AndreeaFG/Project-Circuit-for-controlling-the-concentration-of-CO-in-an-enclosure/PROIECTTCAD.png

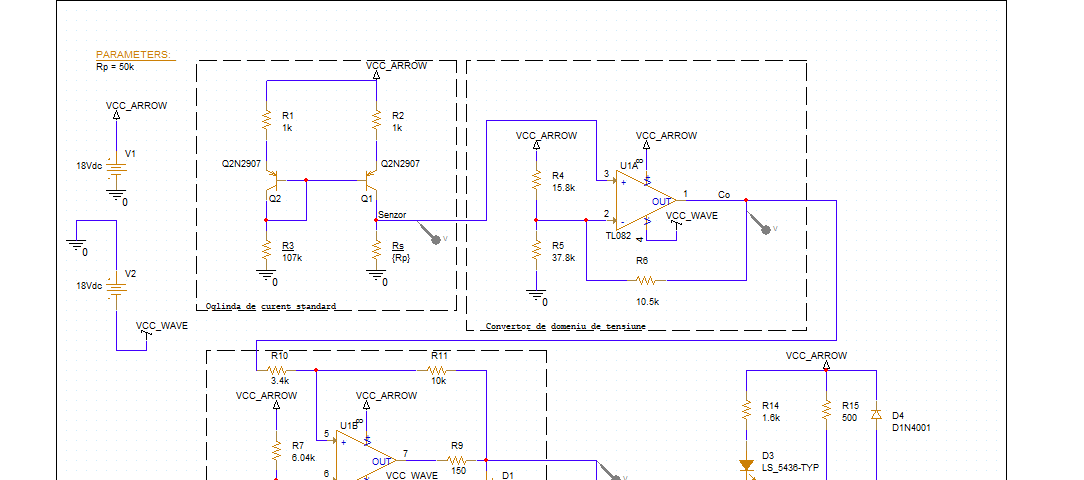
PROIECTTCAD.png
