AndreeaFG/Project-Circuit-for-controlling-the-concentration-of-CO-in-an-enclosure/caract.cir

** Profile: "SCHEMATIC3-caract"  [ C:\Users\Septimiu\Documents\Didactic\alte\2023_2024\tcad\SenzorCO_Orcad\ProiectTCAD-PSpiceFiles\SCHEMATIC3\caract.sim ] 

** Creating circuit file "caract.cir" 
** WARNING: THIS AUTOMATICALLY GENERATED FILE MAY BE OVERWRITTEN BY SUBSEQUENT SIMULATIONS

*Libraries: 
* Profile Libraries :
* Local Libraries :
* From [PSPICE NETLIST] section of C:\Users\Septimiu\AppData\Roaming\SPB_Data\cdssetup\OrCAD_PSpice/16.6.0/PSpice.ini file:
.lib "nom.lib" 

*Analysis directives: 
.DC LIN V_V1 0 30 0.5 
.OPTIONS ADVCONV
.PROBE64 V(alias(*)) I(alias(*)) W(alias(*)) D(alias(*)) NOISE(alias(*)) 
.INC "..\SCHEMATIC3.net" 


.END
