AndreeaFG/Project-Circuit-for-controlling-the-concentration-of-CO-in-an-enclosure/(list of files, drawings)

Other design files:
PROIECTTCAD.DSN
ProiectTCAD.opj
